AeroQuad/FlightControlBoards/AeroQuadTiny v1.0/AeroQuadTiny_v100.pdf

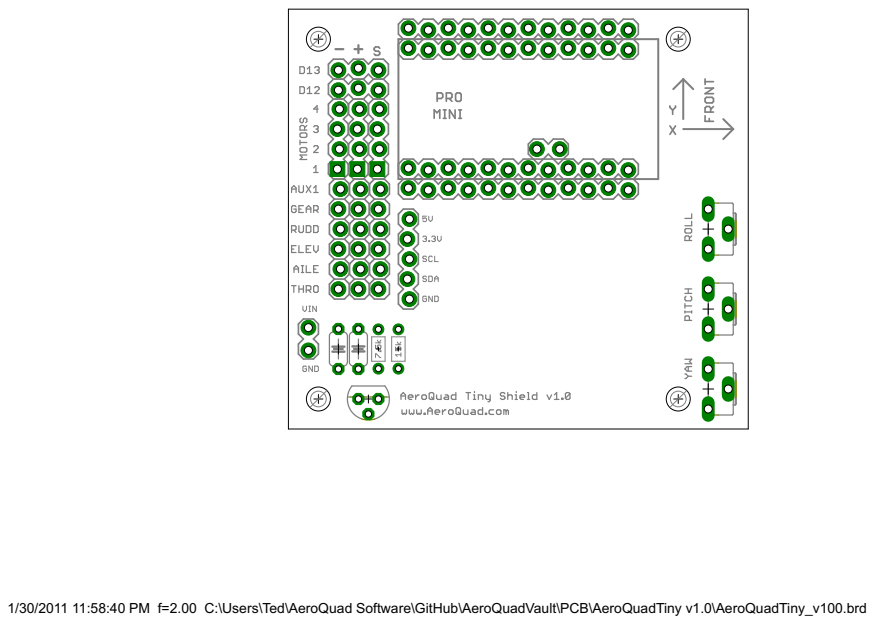
[picture p1: page 1]

1/30/2011 11:58:40 PM f=2.00 C:\Users\Ted\AeroQuad Software\GitHub\AeroQuadVault\PCB\AeroQuadTiny v1.0\AeroQuadTiny_v100.brd
