AeroQuad/FlightControlBoards/AeroQuad_v2.1/AeroQuad_v210_Schematic.pdf

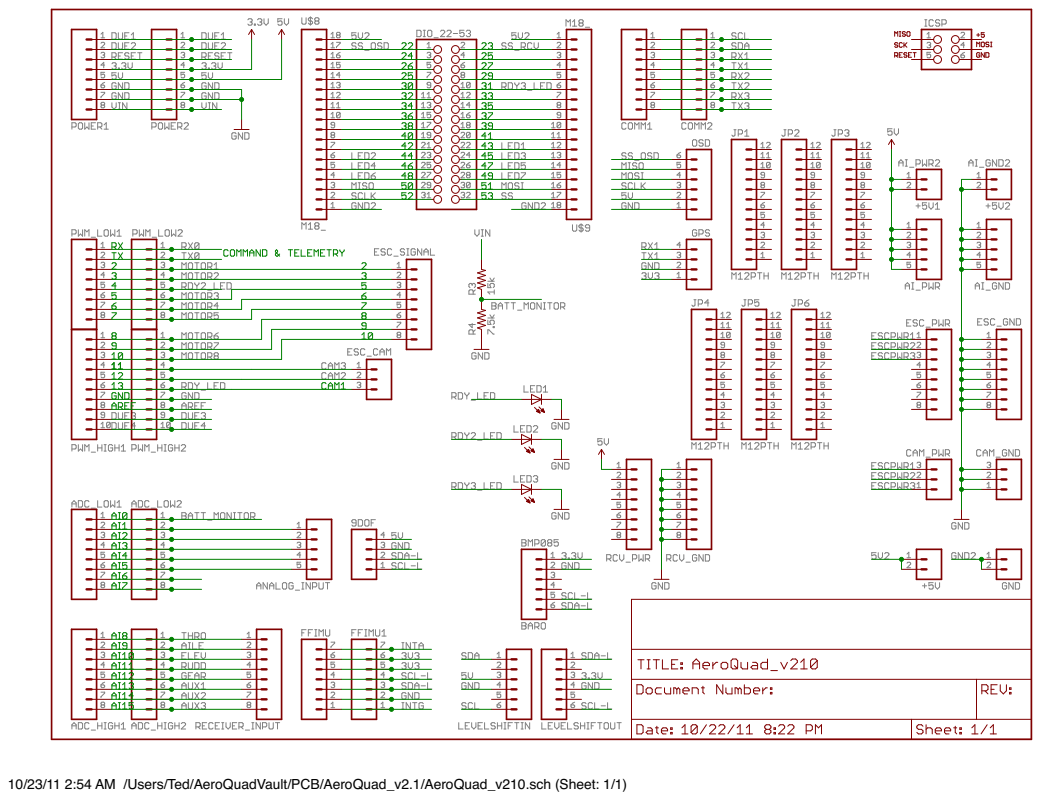
[picture p2: page 1]

10/23/11 2:54 AM /Users/Ted/AeroQuadVault/PCB/AeroQuad_v2.1/AeroQuad_v210.sch (Sheet: 1/1)
