AeroQuad/FlightControlBoards/AeroQuad_v2.0.6/AeroQuad_v206_Schematic.pdf

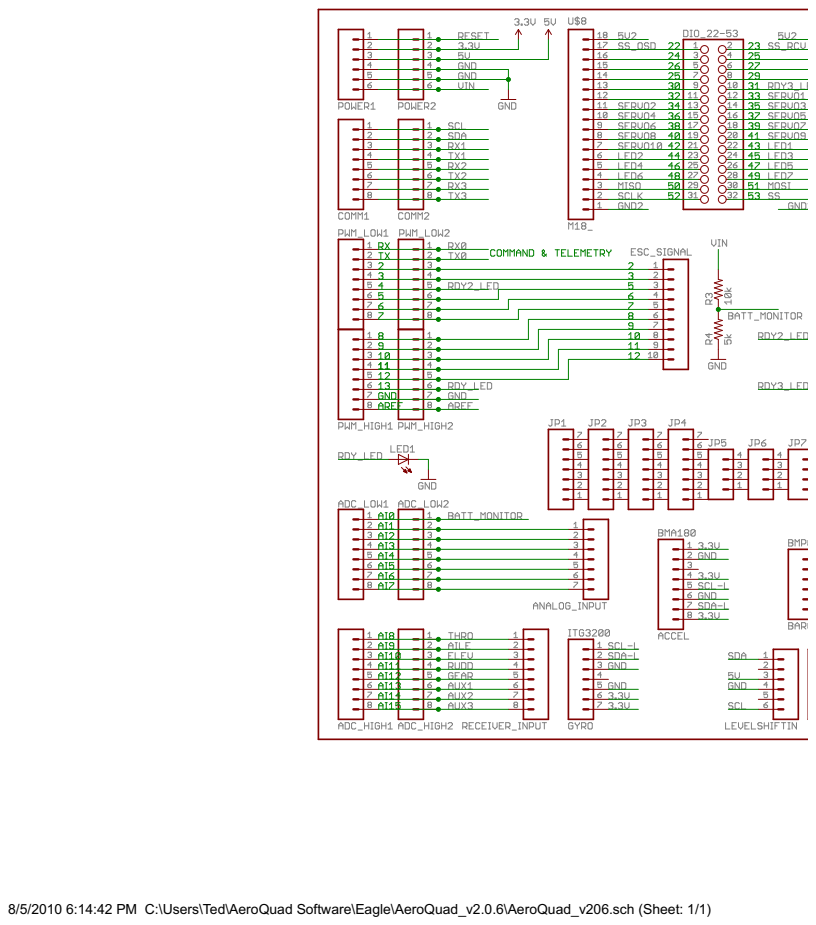
[picture p4: page 1]

8/5/2010 6:14:42 PM C:\Users\Ted\AeroQuad Software\Eagle\AeroQuad_v2.0.6\AeroQuad_v206.sch (Sheet: 1/1)

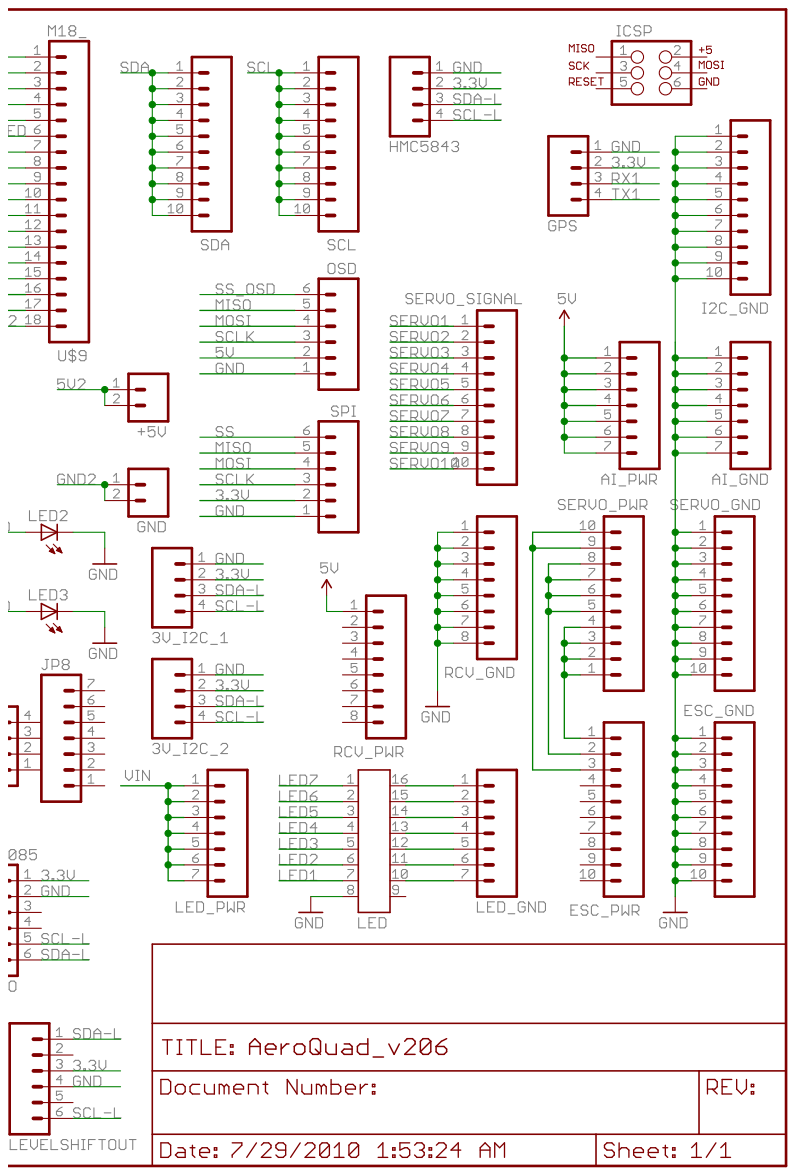
[picture p5: page 2]
