AeroQuad/FlightControlBoards/AQ32_v2/AQ32_v2.brd

## EAGLE design AQ32_v2/AQ32_v2.brd (2013-07-10)

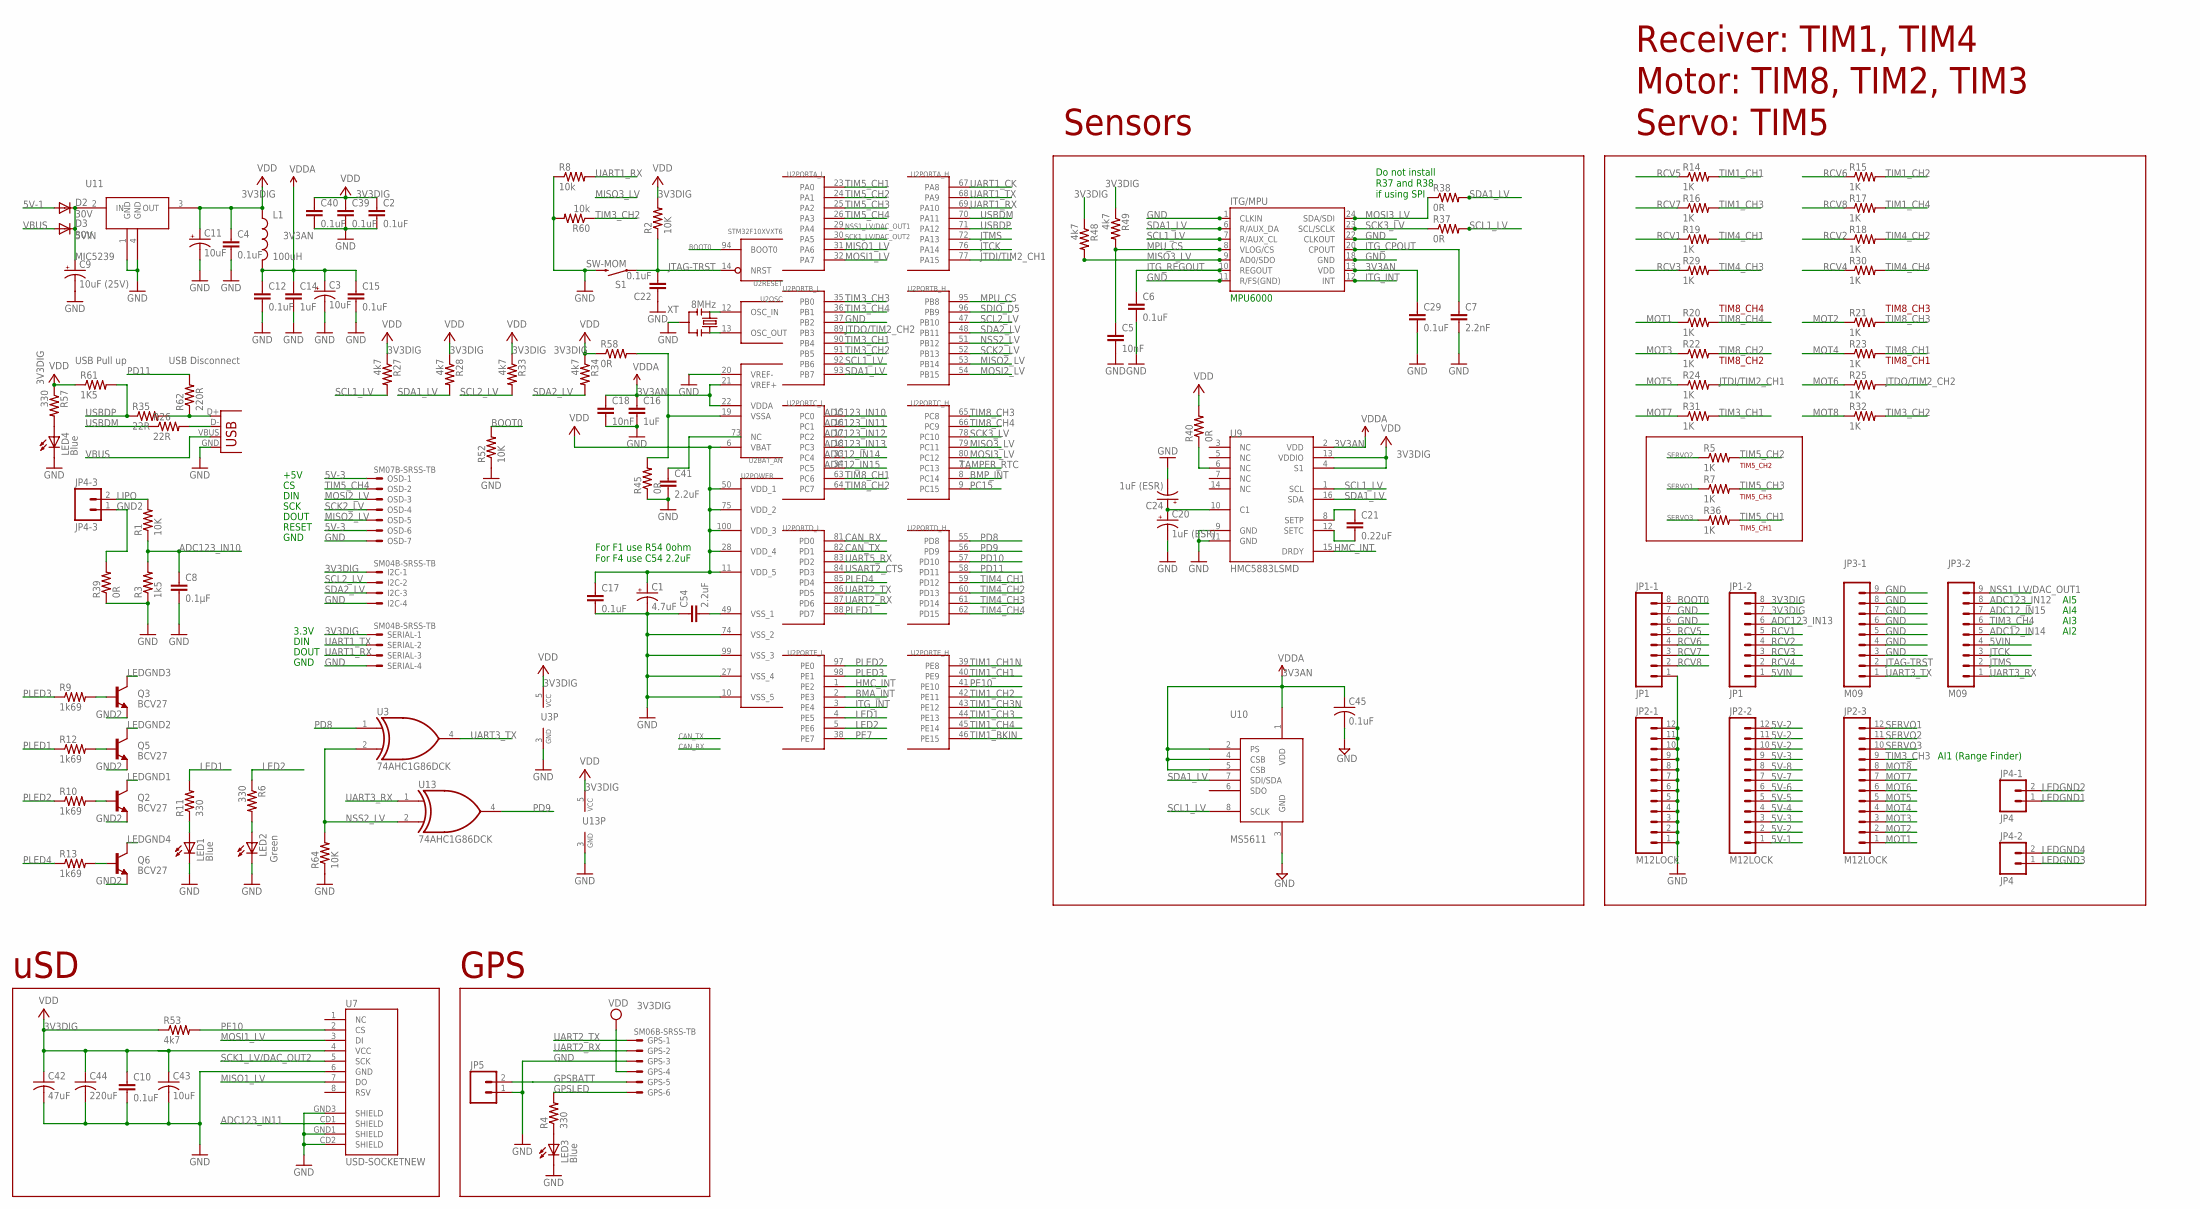
[picture p8: schematic AQ32_v2.sch]

Parts:
C1: 4.7uF; SMC_Z
C2, C4, C6, C10, C12, C15, C17, C22, C29, C39, C40, C45: 0.1uF; C0402
C3, C11: 10uF; EIA3216
C5, C18: 10nF; C0402
C7: 2.2nF; C0402
C8: 0.1µF; C0402
C9: 10uF (25V); EIA3216
C14, C16: 1uF; C0402
C20, C24: 1uF (ESR); SMC_Z
C21: 0.22uF; C0402
C41: 2.2uF; C0402
C42: 47uF; C0805
C43: 10uF; C0805
C44: 220uF; C1206
C54: 2.2uF; 0402-CAP
D2, D3: 30V; SOD-323
GPS: SM06B-SRSS-TB
I2C: SM04B-SRSS-TB
JP1-1, JP1-2: JP1; 1X08_LOCK
JP2-1, JP2-2, JP2-3: M12LOCK; 1X12_LOCK
JP3-1, JP3-2: M09; 1X09
JP4-1, JP4-2: JP4; 1X02
JP4-3: JP4-3; 1X02
JP5: M02PTH; 1X02
L1: 100uH; 0805
LED1, LED3, LED4: Blue; LED-0603
LED2: Green; LED-0603
OSD: SM07B-SRSS-TB
Q2, Q3, Q5, Q6: BCV27; SOT23-3
R1, R2, R52, R64: 10K; C0402
R3: 1k5; C0402
R4, R6, R11, R57: 330; C0402
R5, R7, R14, R15, R16, R17, R18, R19, R20, R21, R22, R23, R24, R25, R29, R30, R31, R32, R36: 1K; C0402
R8, R60: 10k; R0402
R9, R10, R12, R13: 1k69; C0402
R26, R35: 22R; C0402
R27, R28, R33, R34, R48, R49, R53: 4k7; C0402
R37, R38, R40, R45, R58: 0R; R0402
R39: 0R; C0402
R61: 1K5; R0402
R62: 220R; C0402
S1: SW-MOM; TACTILE_SWITCH_SMD
SERIAL: SM04B-SRSS-TB
U1: ITG-3200; QFN-24
U2: STM32F10XVXT6; TQFP100
U3, U13: 74AHC1G86DCK; SC70-5
U7: USD-SOCKETNEW; MICRO-SD-SOCKET-PP
U9: HMC5883LSMD; 16LPCC
U10: MS5611; LGA08A
U11: MIC5239; TO-223
X2: USBOLD; USB-MINIB-OLD
XT: 8MHz; RESONATOR-SMD

Connections:
3V3AN: C3.A (+), C12.1, C14.1, C15.1, C16.1, C18.1, C29.1, C45.1, L1.2, U1.13 (VDD), U2.21 (VREF+), U2.22 (VDDA), U9.2 (VDD), U10.1 (VDD), U10.2 (PS), U10.4 (CSB), U10.5 (CSB)
3V3DIG: C1.+, C2.1, C4.1, C10.1, C11.A (+), C17.1, C39.1, C40.1, C42.1, C43.1, C44.1, GPS.4, I2C.1, JP1-2.7, JP1-2.8, L1.1, R2.2, R27.1, R28.1, R33.1, R34.1, R40.2, R48.1, R49.1, R53.1, R57.1, R58.1, R61.1, SERIAL.1, U2.6 (VBAT), U2.11 (VDD_5), U2.28 (VDD_4), U2.50 (VDD_1), U2.75 (VDD_2), U2.100 (VDD_3), U3.5 (VCC), U7.4 (VCC), U9.4 (S1), U9.13 (VDDIO), U11.3 (OUT), U13.5 (VCC)
5V-1: D2.2 (A), JP2-2.1
5V-2: JP2-2.2, JP2-2.10, JP2-2.11, JP2-2.12
5V-3: JP2-2.3, JP2-2.9, OSD.1, OSD.6
5V-4: JP2-2.4
5V-5: JP2-2.5
5V-6: JP2-2.6
5V-7: JP2-2.7
5V-8: JP2-2.8
5VIN: C9.A (+), D2.1 (C), D3.1 (C), JP1-2.1, JP3-2.4, U11.2 (IN)
ADC12_IN14: JP3-2.5, U2.33 (PC4)
ADC12_IN15: JP3-2.7, U2.34 (PC5)
ADC123_IN10: C8.1, R1.1, R3.2, U2.15 (PC0)
ADC123_IN11: U2.16 (PC1), U7.CD1 (SHIELD)
ADC123_IN12: JP3-2.8, U2.17 (PC2)
ADC123_IN13: JP1-2.6, U2.18 (PC3)
BMA_INT: U2.2 (PE3)
BMP_INT: U2.8 (PC14)
BOOT0: JP1-1.8, R52.2, U2.94 (BOOT0)
CAN_RX: U2.81 (PD0)
CAN_TX: U2.82 (PD1)
GND: C1.-, C2.2, C3.C (-), C4.2, C5.2, C6.2, C7.2, C8.2, C9.C (-), C10.2, C11.C (-), C12.2, C14.2, C15.2, C16.2, C17.2, C18.2, C20.-, C22.1, C24.-, C29.2, C39.2, C40.2, C41.2, C42.2, C43.2, C44.2, C45.2, C54.1, GPS.3, I2C.4, JP1-1.1, JP1-1.6, JP1-1.7, JP2-1.1, JP2-1.2, JP2-1.3, JP2-1.4, JP2-1.5, JP2-1.6, JP2-1.7, JP2-1.8, JP2-1.9, JP2-1.10, JP2-1.11, JP2-1.12, JP3-1.3, JP3-1.4, JP3-1.5, JP3-1.6, JP3-1.7, JP3-1.8, JP3-1.9, JP5.1, LED1.C, LED2.C, LED3.C, LED4.C, OSD.7, R3.1, R8.1, R39.1, R45.1, R52.1, R60.2, R64.1, S1.3 (2), SERIAL.4, U1.1 (CLKIN), U1.11 (R/FS(GND)), U1.18 (GND), U1.22 (CLKOUT), U2.10 (VSS_5), U2.20 (VREF-), U2.27 (VSS_4), U2.37 (PB2), U2.74 (VSS_2), U2.99 (VSS_3), U3.3 (GND), U7.6 (GND), U7.CD2 (SHIELD), U7.GND1 (SHIELD), U7.GND3 (SHIELD), U9.9 (GND), U9.11 (GND), U10.3 (GND), U11.1 (GND), U11.4 (GND), U13.3 (GND), X2.GND, XT.2
GND2: JP4-3.1, Q2.2 (E), Q3.2 (E), Q5.2 (E), Q6.2 (E), R39.2
GPSBATT: GPS.5, JP5.2
GPSLED: GPS.6, R4.2
HMC_INT: U2.1 (PE2), U9.15 (DRDY)
ITG_CPOUT: C7.1, U1.20 (CPOUT)
ITG_INT: U1.12 (INT), U2.3 (PE4)
ITG_REGOUT: C6.1, U1.10 (REGOUT)
JTAG-TRST: C22.2, JP3-1.2, R2.1, S1.1, U2.14 (NRST)
JTCK: JP3-2.3, U2.76 (PA14)
JTDI/TIM2_CH1: R24.2, U2.77 (PA15)
JTDO/TIM2_CH2: R25.2, U2.89 (PB3)
JTMS: JP3-2.2, U2.72 (PA13)
LED1: R11.2, U2.4 (PE5)
LED2: R6.1, U2.5 (PE6)
LEDGND1: JP4-1.1, Q2.3 (C)
LEDGND2: JP4-1.2, Q5.3 (C)
LEDGND3: JP4-2.1, Q3.3 (C)
LEDGND4: JP4-2.2, Q6.3 (C)
LIPO: JP4-3.2, R1.2
MISO1_LV: U2.31 (PA6), U7.7 (DO)
MISO2_LV: OSD.5, U2.53 (PB14)
MISO3_LV: R48.2, U1.9 (AD0/SDO), U2.79 (PC11)
MOSI1_LV: U2.32 (PA7), U7.3 (DI)
MOSI2_LV: OSD.3, U2.54 (PB15)
MOSI3_LV: R38.1, U1.24 (SDA/SDI), U2.80 (PC12)
MOT1: JP2-3.1, R20.1
MOT2: JP2-3.2, R21.1
MOT3: JP2-3.3, R22.1
MOT4: JP2-3.4, R23.1
MOT5: JP2-3.5, R24.1
MOT6: JP2-3.6, R25.1
MOT7: JP2-3.7, R31.1
MOT8: JP2-3.8, R32.1
MPU_CS: C5.1, R49.2, U1.8 (VLOG/CS), U2.95 (PB8)
unnamed: U2.12 (OSC_IN), XT.3
unnamed: U2.13 (OSC_OUT), XT.1
unnamed: LED3.A, R4.1
unnamed: R40.1, U9.6 (NC)
unnamed: LED2.A, R6.2
unnamed: Q3.1 (B), R9.2
unnamed: C54.2, U2.49 (VSS_1)
unnamed: Q2.1 (B), R10.2
unnamed: Q5.1 (B), R12.2
unnamed: LED1.A, R11.1
unnamed: Q6.1 (B), R13.2
unnamed: C41.1, U2.73 (NC)
unnamed: LED4.A, R57.2
unnamed: R45.2, R58.2, U2.19 (VSSA)
unnamed: C21.1, U9.8 (SETP)
unnamed: C21.2, U9.12 (SETC)
unnamed: C20.+, C24.+, U9.10 (C1)
unnamed: R35.2, R62.1, X2.D+
unnamed: R26.2, X2.D-
NSS1_LV/DAC_OUT1: JP3-2.9, U2.29 (PA4)
NSS2_LV: R64.2, U2.51 (PB12), U3.2 (I1), U13.2 (I1)
PC15: U2.9 (PC15)
PD8: U2.55 (PD8), U3.1 (I0)
PD9: U2.56 (PD9), U13.4 (O)
PD10: U2.57 (PD10)
PD11: R62.2, U2.58 (PD11)
PE7: U2.38 (PE7)
PE10: R53.2, U2.41 (PE10), U7.2 (CS)
PLED1: R12.1, U2.88 (PD7)
PLED2: R10.1, U2.97 (PE0)
PLED3: R9.1, U2.98 (PE1)
PLED4: R13.1, U2.85 (PD4)
RCV1: JP1-2.5, R19.1
RCV2: JP1-2.4, R18.1
RCV3: JP1-2.3, R29.1
RCV4: JP1-2.2, R30.1
RCV5: JP1-1.5, R14.1
RCV6: JP1-1.4, R15.1
RCV7: JP1-1.3, R16.1
RCV8: JP1-1.2, R17.1
SCK1_LV/DAC_OUT2: U2.30 (PA5), U7.5 (SCK)
SCK2_LV: OSD.4, U2.52 (PB13)
SCK3_LV: R37.1, U1.23 (SCL/SCLK), U2.78 (PC10)
SCL1_LV: R27.2, R37.2, U1.7 (R/AUX_CL), U2.92 (PB6), U9.1 (SCL), U10.8 (SCLK)
SCL2_LV: I2C.2, R33.2, U2.47 (PB10)
SDA1_LV: R28.2, R38.2, U1.6 (R/AUX_DA), U2.93 (PB7), U9.16 (SDA), U10.7 (SDI/SDA)
SDA2_LV: I2C.3, R34.2, U2.48 (PB11)
SDIO_D5: U2.96 (PB9)
SERVO1: JP2-3.12, R7.1
SERVO2: JP2-3.11, R5.1
SERVO3: JP2-3.10, R36.1
TAMPER_RTC: U2.7 (PC13)
TIM1_BKIN: U2.46 (PE15)
TIM1_CH1: R14.2, U2.40 (PE9)
TIM1_CH1N: U2.39 (PE8)
TIM1_CH2: R15.2, U2.42 (PE11)
TIM1_CH3: R16.2, U2.44 (PE13)
TIM1_CH3N: U2.43 (PE12)
TIM1_CH4: R17.2, U2.45 (PE14)
TIM3_CH1: R31.2, U2.90 (PB4)
TIM3_CH2: R32.2, R60.1, U2.91 (PB5)
TIM3_CH3: JP2-3.9, U2.35 (PB0)
TIM3_CH4: JP3-2.6, U2.36 (PB1)
TIM4_CH1: R19.2, U2.59 (PD12)
TIM4_CH2: R18.2, U2.60 (PD13)
TIM4_CH3: R29.2, U2.61 (PD14)
TIM4_CH4: R30.2, U2.62 (PD15)
TIM5_CH1: R36.2, U2.23 (PA0)
TIM5_CH2: R5.2, U2.24 (PA1)
TIM5_CH3: R7.2, U2.25 (PA2)
TIM5_CH4: OSD.2, U2.26 (PA3)
TIM8_CH1: R23.2, U2.63 (PC6)
TIM8_CH2: R22.2, U2.64 (PC7)
TIM8_CH3: R21.2, U2.65 (PC8)
TIM8_CH4: R20.2, U2.66 (PC9)
UART1_CK: U2.67 (PA8)
UART1_RX: R8.2, SERIAL.3, U2.69 (PA10)
UART1_TX: SERIAL.2, U2.68 (PA9)
UART2_RX: GPS.2, U2.87 (PD6)
UART2_TX: GPS.1, U2.86 (PD5)
UART3_RX: JP3-2.1, U13.1 (I0)
UART3_TX: JP3-1.1, U3.4 (O)
UART5_RX: U2.83 (PD2)
USART2_CTS: U2.84 (PD3)
USBDM: R26.1, U2.70 (PA11)
USBDP: R35.1, R61.2, U2.71 (PA12)
VBUS: D3.2 (A), X2.VBUS

Notes on the sheet:
Receiver: TIM1, TIM4
Motor: TIM8, TIM2, TIM3
Servo: TIM5
USB Pull up
USB Disconnect
MPU6000
Sensors
uSD
GPS
TIM8_CH4
TIM8_CH1
TIM8_CH3
TIM8_CH2
TIM5_CH2
TIM5_CH1
TIM5_CH3
+5V
DIN
SCK
DOUT
RESET
GND
3.3V
AI1 (Range Finder)
AI2
AI3
AI4
AI5
Do not install R37 and R38 if using SPI
For F1 use R54 0ohm For F4 use C54 2.2uF

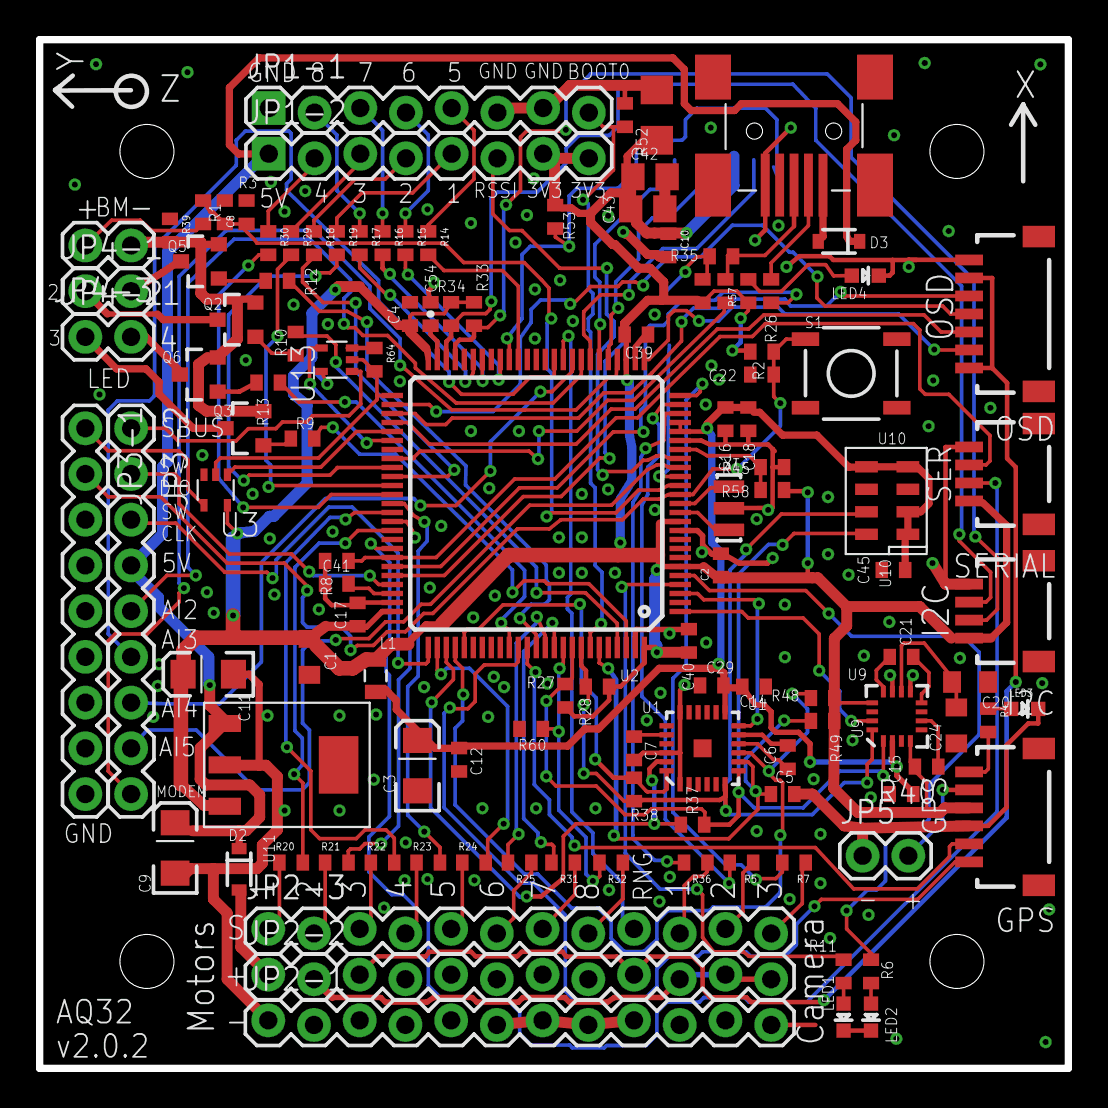
[picture p9: board AQ32_v2.brd from above]

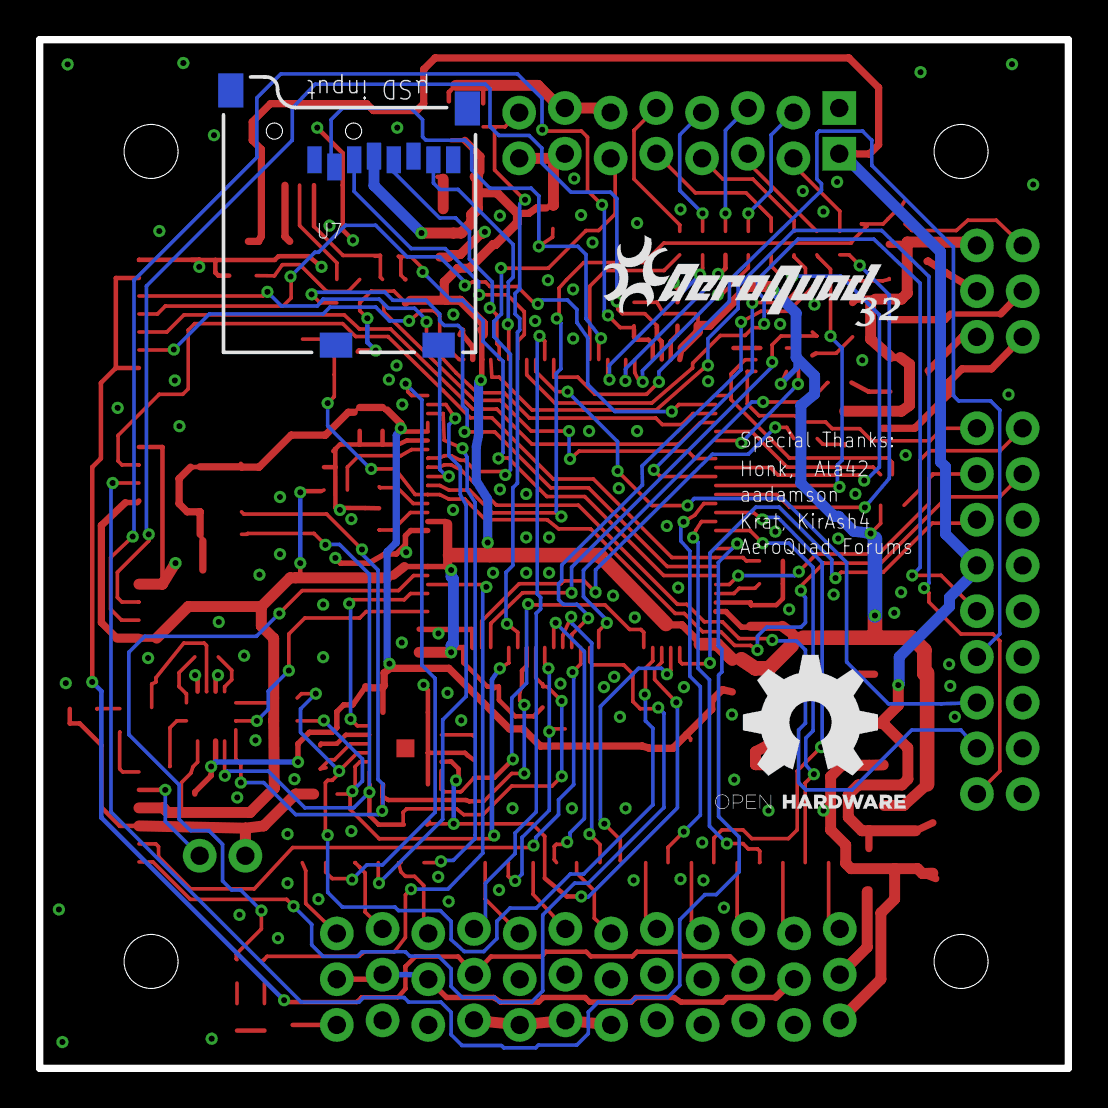
[picture p10: board AQ32_v2.brd from below]

Board: 2 copper layers, 57.1 x 57.1 mm, 120 parts (3 on the bottom side), 124 nets.

Other parts of the board:
U$4: AQ-WORDS-PT07
U$5: OSHW_TEXT
