AeroQuad/FlightControlBoards/(commit log)

2012-01-07 Initial Check In
    [AeroQuadMiniBare_v100.brd, AeroQuadMiniBare_v100.sch, AeroQuadMiniProto_v100.brd, AeroQuadMiniProto_v100.sch, AeroQuadMini_v105.brd, AeroQuadMini_v105.sch, AeroQuadMini_v201.brd, AeroQuadMini_v201.sch]
2012-05-31 AeroQuad 32 Board Eagle Files
    [AQ_Baloo_t.brd, AQ_Baloo_t.sch, AeroQuad_v300.brd, AeroQuad_v300.sch]
2012-06-01 adding BOM for AeroQuad 32 board
2012-06-11 Eagle files including CAM file for latest beta run of AeroQuad32 boards.
    [AeroQuad32.brd, AeroQuad32.sch, AeroQuad_v300.brd, AeroQuad_v300.sch]
2012-06-28 reviewed MPU6000 circuit and connections to Due
    [AeroQuad_v300.brd, AeroQuad_v300.sch]
2012-07-03 updated v2.1.3 shield with fixed 3.3V for GPS and added 5V reset line for OSD
    [AeroQuad_v213.brd, AeroQuad_v213.sch, AeroQuad_v300.brd, AeroQuad_v300.sch]
2012-08-08 fixed LED driver bug, added support for SBUS and fixed GPS connector pinout
    [AQ_Baloo_t.brd, AQ_Baloo_t.sch, AeroQuad32.brd, AeroQuad32.sch]
2013-04-08 Initial Check In for AQ32 v2
    [AQ32_v2.brd, AQ32_v2.sch, AQ32_v2.xlsx]
2013-04-13 completed connections to external JST connectors
    [AQ32_v2.brd, AQ32_v2.sch]
2013-04-15 move LEDs to separate connector, connected baro to SPI
    [AQ32_v2.brd, AQ32_v2.sch, AQ32_v2.xlsx]
2013-04-15 added ground pin for GPS battery
    [AQ32_v2.brd, AQ32_v2.sch]
2013-04-15 converted baro back to using I2C, renamed TX4/TX5 to use I2C3 labels
    [AQ32_v2.brd, AQ32_v2.sch]
2013-04-17 fixed airwires
    [AQ32_v2.brd, AQ32_v2.sch]
2013-04-17 fixed clearance issues
    [AQ32_v2.brd]
2013-04-17 Beefed up +5V in and ground traces
    [AQ32_v2.brd]
2013-04-18 general route cleanup
    [AQ32_v2.brd]
2013-04-18 cleanup of BOM
    [AQ32_v2.xlsx, AQ32_v2_BOM.xlsx]
2013-04-18 remove old BOM
    [AQ32_v2.xlsx]
2013-04-18 Removed capacitor (C45) guess for link
    [AQ32_v2_BOM.xlsx]
2013-04-20 relocated BM input away from 3.3V input, added more clearance between mounting holes and USB input, added XOR gate to SBUS TX, added ground plane to top side of board
    [AQ32_v2.brd, AQ32_v2.sch]
2013-04-20 layout cleanup
    [AQ32_v2.sch]
2013-04-20 fixed SBUS Tx connection, fixed clearance issue with updated XOR connections, added extra vias for ground
    [AQ32_v2.brd, AQ32_v2.sch]
2013-04-23 moved vias away from under sensors, added more gnd vias, cleaned up BOM
    [AQ32_v2.brd, AQ32_v2.sch, AQ32_v2_BOM.xlsx]
2013-04-24 moved BM closer to LED control, improved grounding for LED's
    [AQ32_v2.brd, AQ32_v2.sch]
2013-04-25 reverted to fixed ground plane for BM and LED GND's, moved lavels
    [AQ32_v2.brd, AQ32_v2.sch]
2013-04-28 "j" version from Alfred
    [AQ32_v2.brd, AQ32_v2.sch]
2013-04-28 Revert ""j" version from Alfred"
    This reverts commit dfbd99c4a951c4a7fc19233cae0e41e3843b112f.
    [AQ32_v2.brd, AQ32_v2.sch]
2013-04-28 change LED connector type for normal 100mil pitch
    [AQ32_v2.brd, AQ32_v2.sch]
2013-04-29 Changes from ala42 20130428
    [AQ32_v2.brd]
2013-04-29 Begin work on Due compatible AQ shield
    [AeroQuad_v300.brd, AeroQuad_v300.sch]
2013-04-29 Isolate BM/LED GND from main GND using 0R resistor. More clearance around holes.
    [AQ32_v2.brd, AQ32_v2.sch]
2013-04-30 Remove traces under mag.
    [AQ32_v2.brd]
2013-05-23 added camera servo pins, starting overall review of other Due pins
    [AeroQuad_v300.brd, AeroQuad_v300.sch]
2013-05-27 Latest from Alfred (20130526_b)
    [AQ32_v2.brd, AQ32_v2.sch]
2013-07-04 Ala42 added HMC5983 support, remapped receiver/motor lines to match v1 board, moved mag to avoid interference, made space for standoffs by moving uSD conenctor, made power lines thicker
    [AQ32_v2.brd, AQ32_v2.sch, AQ32_v2_BOM.xlsx]
2013-07-04 removed uSD connector ferrit bead, increased the font sizes
    [AQ32_v2.brd, AQ32_v2.sch]
2013-07-10 ala42 added blocking cap for uSD (C10), updated silkscreen to v2.0.2, replaced R54 to C54 (2.2uF) for F4 compatibility
    [AQ32_v2.brd, AQ32_v2.sch, AQ32_v2_BOM.xlsx]
